kamorrissey/SolarDaisy/kicad/solar-light-charlie-boost/solar-light-charlie-boost.jpg

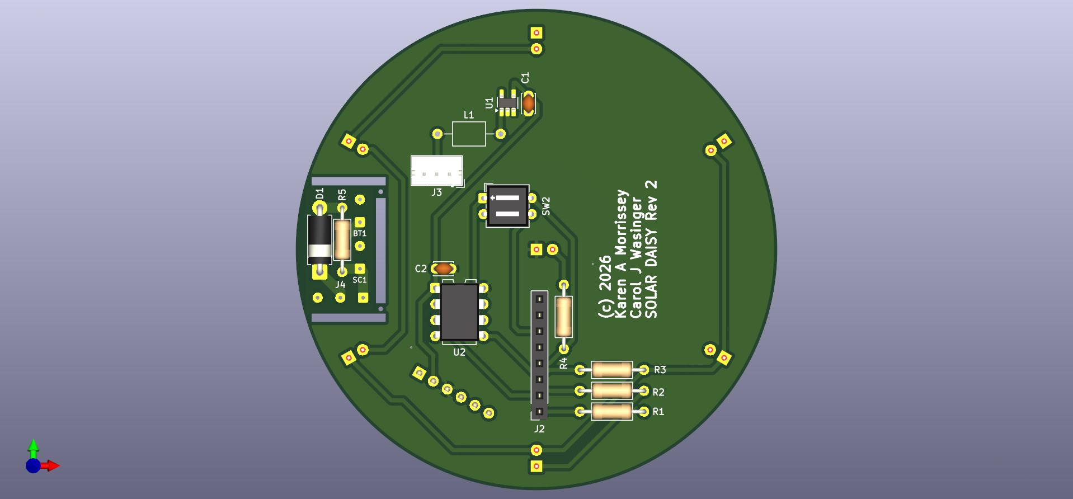
kicad/solar-light-charlie-boost/solar-light-charlie-boost.jpg
