kamorrissey/SolarDaisy/artifacts/gerbers-charlie-boost-v2a/solar-light-charlie-boost.csv

Id | Designator | Footprint | Quantity | Designation | Supplier and ref
1 | D1 | D_DO-15_P10.16mm_Horizontal | 1 | 1N5817
2 | C3,C1 | C_Disc_D3.0mm_W2.0mm_P2.50mm | 2 | 10uF
3 | R7,R8 | R_Axial_DIN0207_L6.3mm_D2.5mm_P10.16mm_Horizontal | 2 | 10K
4 | SC1 | SolderWire-0.1sqmm_1x02_P3.6mm_D0.4mm_OD1mm | 1 | 2V 130mA
5 | R5 | R_Axial_DIN0207_L6.3mm_D2.5mm_P10.16mm_Horizontal | 1 | 0R
6 | R2,R3,R1 | R_Axial_DIN0207_L6.3mm_D2.5mm_P10.16mm_Horizontal | 3 | 47R
7 | U1 | SOT-23-5_HandSoldering | 1 | TPS613221ADBVR
8 | R4 | R_Axial_DIN0207_L6.3mm_D2.5mm_P10.16mm_Horizontal | 1 | 100R
9 | R6 | R_Axial_DIN0207_L6.3mm_D2.5mm_P10.16mm_Horizontal | 1 | 47K
10 | J3 | JST_PH_B3B-PH-K_1x03_P2.00mm_Vertical | 1 | Conn_01x03_Pin
11 | U2 | DIP-8_W7.62mm | 1 | PIC12F1572
12 | J4 | SolderWire-0.1sqmm_1x03_P3.6mm_D0.4mm_OD1mm | 1 | Conn_01x03_Socket
13 | L1 | L_Axial_L5.0mm_D3.6mm_P10.00mm_Horizontal_Murata_BL01RN1A2A2 | 1 | 10uH
14 | C2 | C_Disc_D3.0mm_W2.0mm_P2.50mm | 1 | 100nF
15 | BT1 | SolderWire-0.1sqmm_1x02_P3.6mm_D0.4mm_OD1mm | 1 | NiMH 1.2V 1300mAh
16 | J2 | PinSocket_1x08_P2.54mm_Vertical | 1 | Conn_01x08_Socket
17 | SW2 | SW_DIP_SPSTx02_Slide_6.7x6.64mm_W7.62mm_P2.54mm_LowProfile | 1 | SW_DIP_x02
18 | D8,D6,D7,D2,D5,D4,D3 | LED_D5.0mm | 7 | LED
19 | J5 | PinHeader_1x06_P2.54mm_Horizontal | 1 | ICSP
