kamorrissey/SolarDaisy/solidworks/MainBoard.SLDPRT

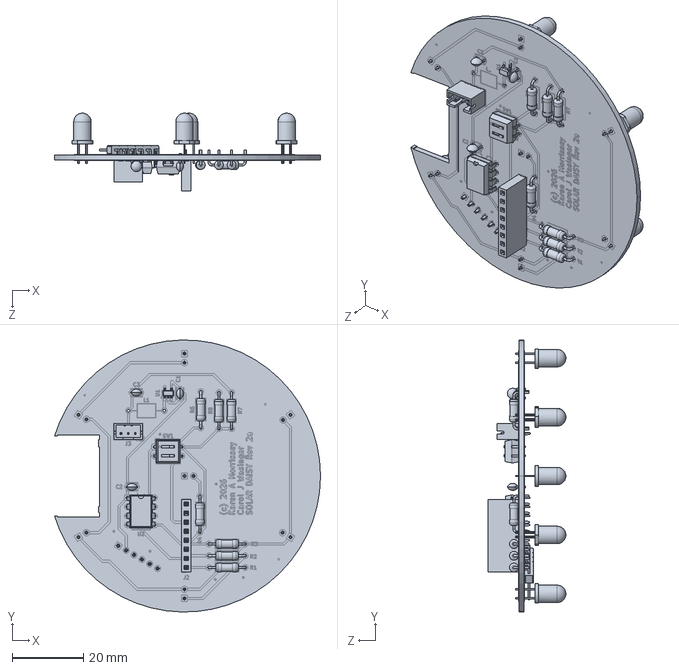
[picture p2: CAD file, 2026-11-04]
solidworks/MainBoard.SLDPRT
74.5 x 76.2 x 21.8 mm
