kamorrissey/SolarDaisy/solidworks/SolarDaisy 2026.SLDASM

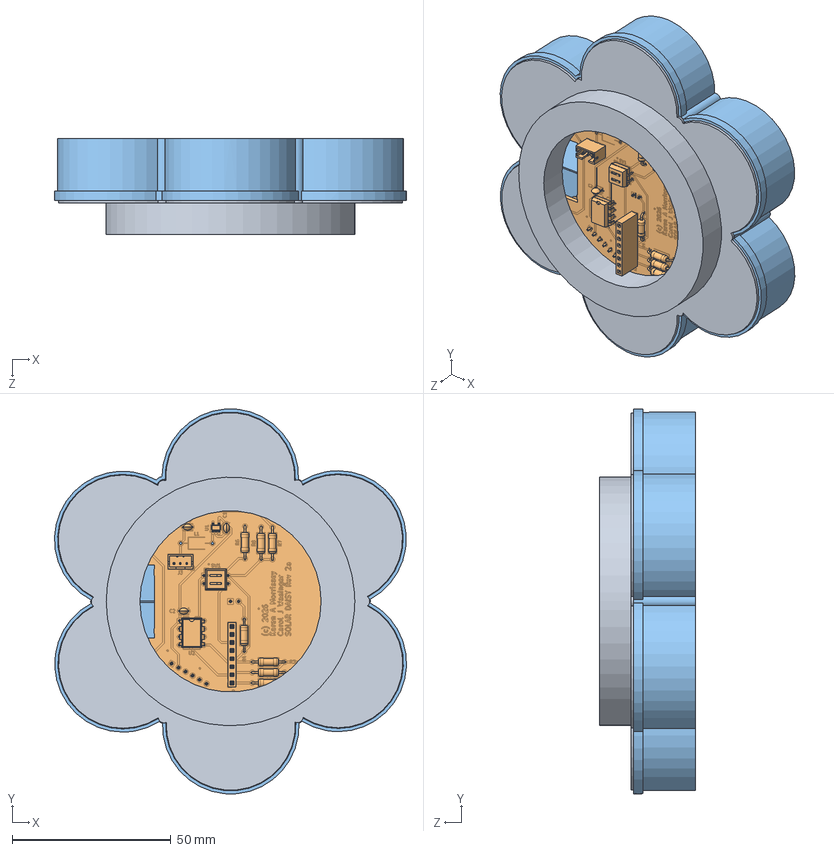
[picture p3: CAD file, 2026-11-04]
solidworks/SolarDaisy 2026.SLDASM
110.8 x 121.1 x 30.3 mm
SolarDaisyFace
MainBoard
SolarDaisyBack 2026
