kamorrissey/SolarDaisy/solidworks/SolarDaisyFace.SLDPRT

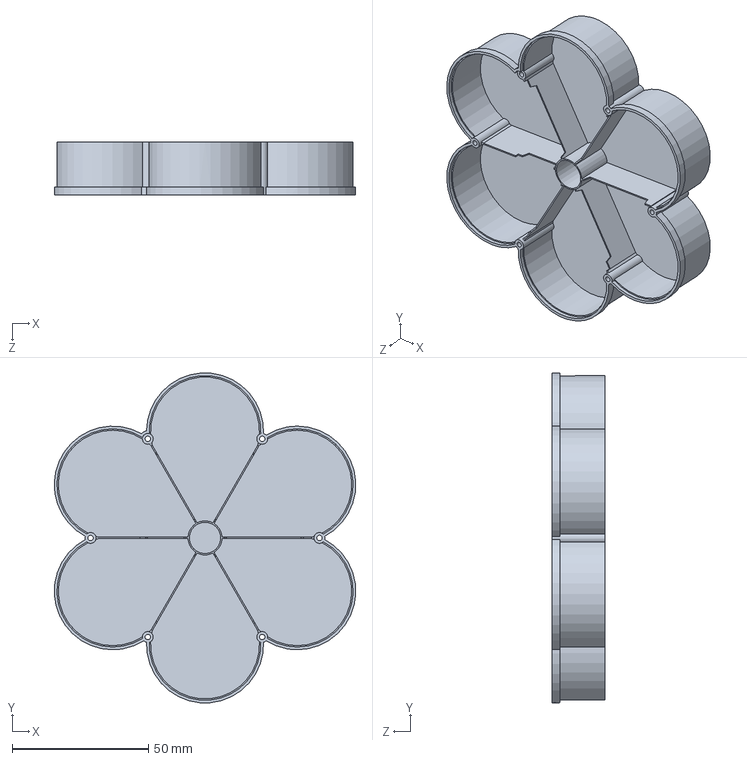
[picture p4: CAD file, 2026-11-04]
solidworks/SolarDaisyFace.SLDPRT
110.7 x 121.1 x 19.5 mm
