kamorrissey/SolarDaisy/solidworks/SolarDaisyBack 2026.SLDPRT

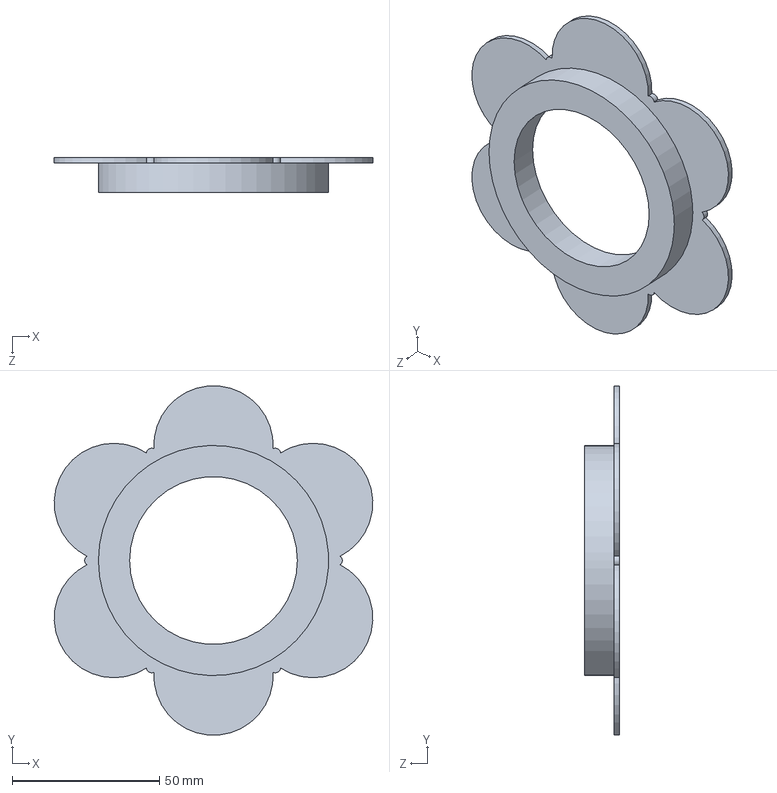
[picture p5: CAD file, 2026-11-04]
solidworks/SolarDaisyBack 2026.SLDPRT
108.3 x 118.6 x 12.0 mm
