kamorrissey/SolarDaisy/solidworks/solar-light-charlie-boost.step

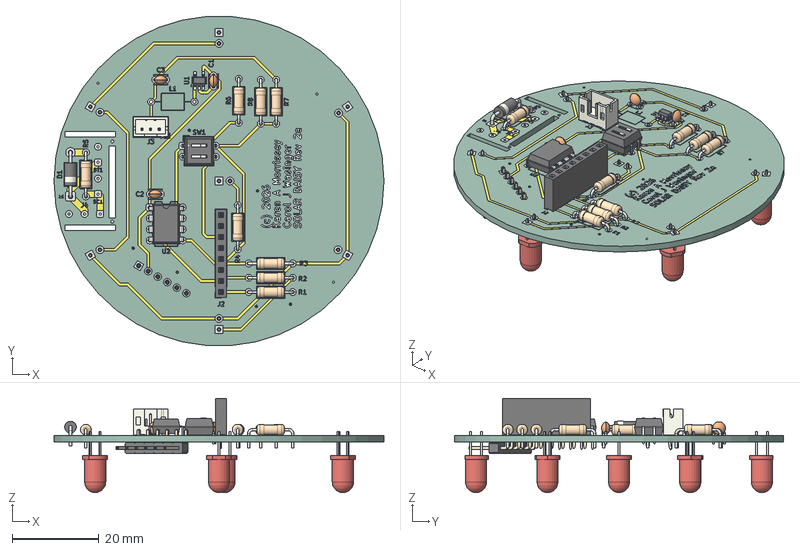
[picture p6: CAD file, 2026-11-04]
solidworks/solar-light-charlie-boost.step
76.2 x 76.0 x 21.8 mm
D_DO-41_SOD81_P10.16mm_Horizontal
R_Axial_DIN0207_L63mm_D25mm_P1016mm_Horizontal x 8
SOT-23-5
JST_B3B_PH_K
DIP-8_W7.62mm
C_Disc_D30mm_W20mm_P250mm x 3
PinSocket_1x08_P2.54mm_Vertical
SW_DIP_SPSTx02_Slide_67x664mm_W762mm_P254mm_LowProfile
LED_D5.0mm x 7
PinHeader_1x06_P254mm_Horizontal
solar-light-charlie-boost_copper
solar-light-charlie-boost_pad
solar-light-charlie-boost_via
solar-light-charlie-boost_silkscreen x 2
solar-light-charlie-boost_PCB
