kamorrissey/SolarDaisy/solidworks/BreakawayBoard.SLDPRT

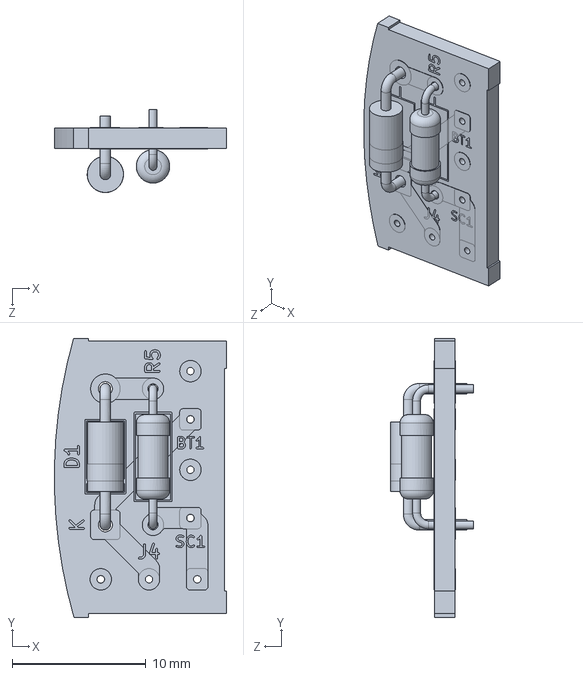
[picture p7: CAD file, 2026-11-04]
solidworks/BreakawayBoard.SLDPRT
12.8 x 20.8 x 6.21 mm
