kamorrissey/SolarDaisy/(list of files, cad)

Other CAD files:
solidworks/solar-light-charlie-boost.SLDPRT
