kamorrissey/SolarDaisy/artifacts/solar-light-charlie-boost.pdf

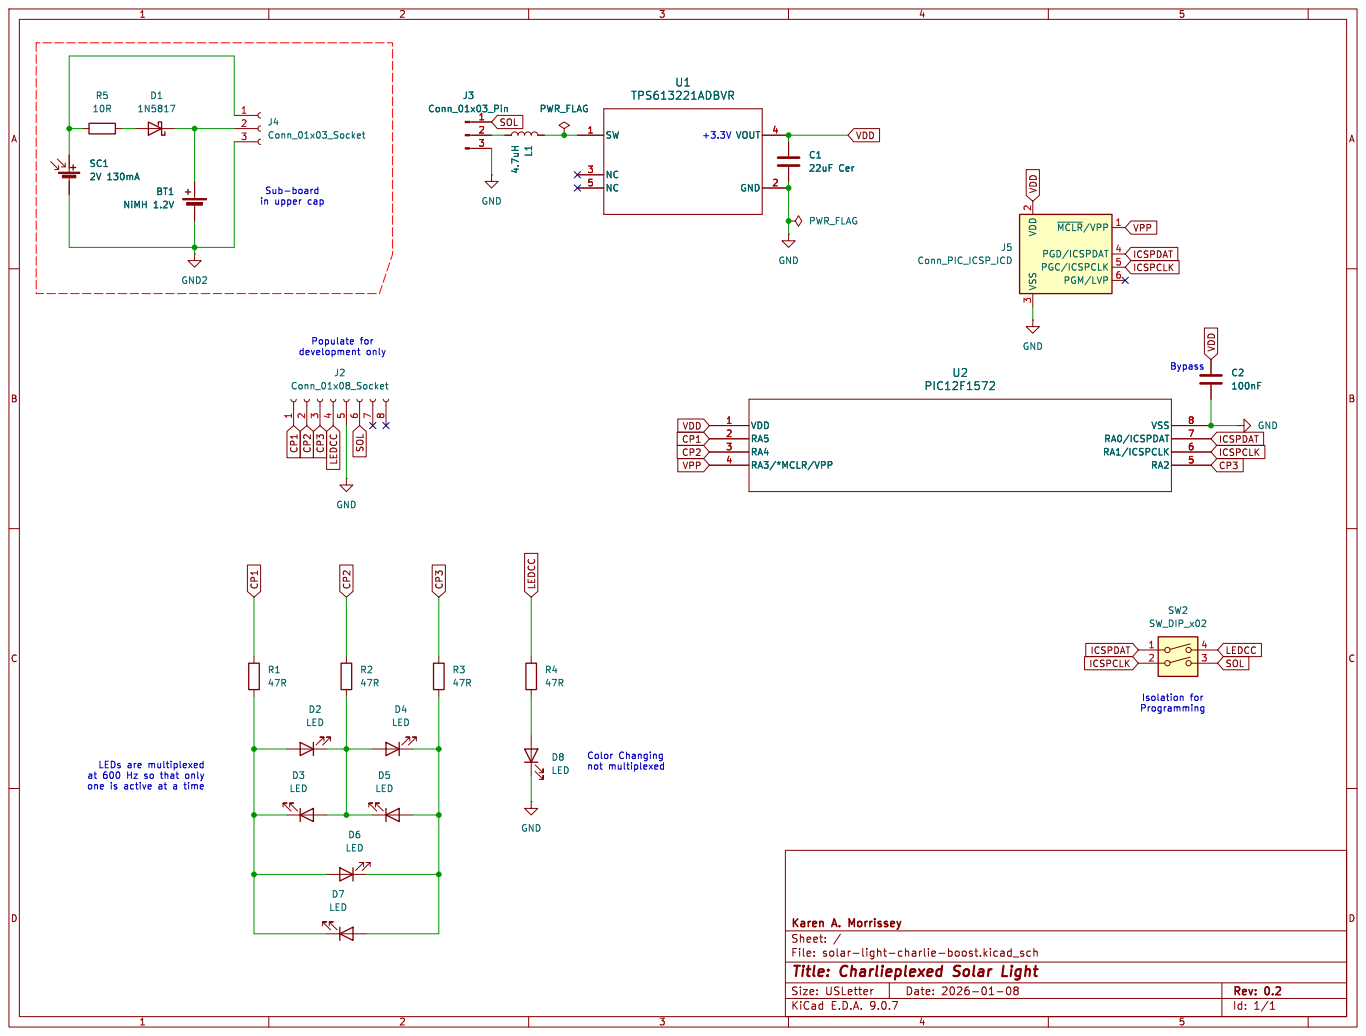
[picture p8: page 1]

3 ~{MCLR}/VPP1 PGD/ICSPDAT 4 PGC/ICSPCLK 5 PGM/LVP 6
