kamorrissey/SolarDaisy/kicad/solar-light-charlie-boost/solar-light-charlie-boost.kicad_pcb

## KiCad design kicad/solar-light-charlie-boost/solar-light-charlie-boost.kicad_pcb (2026-10-26)

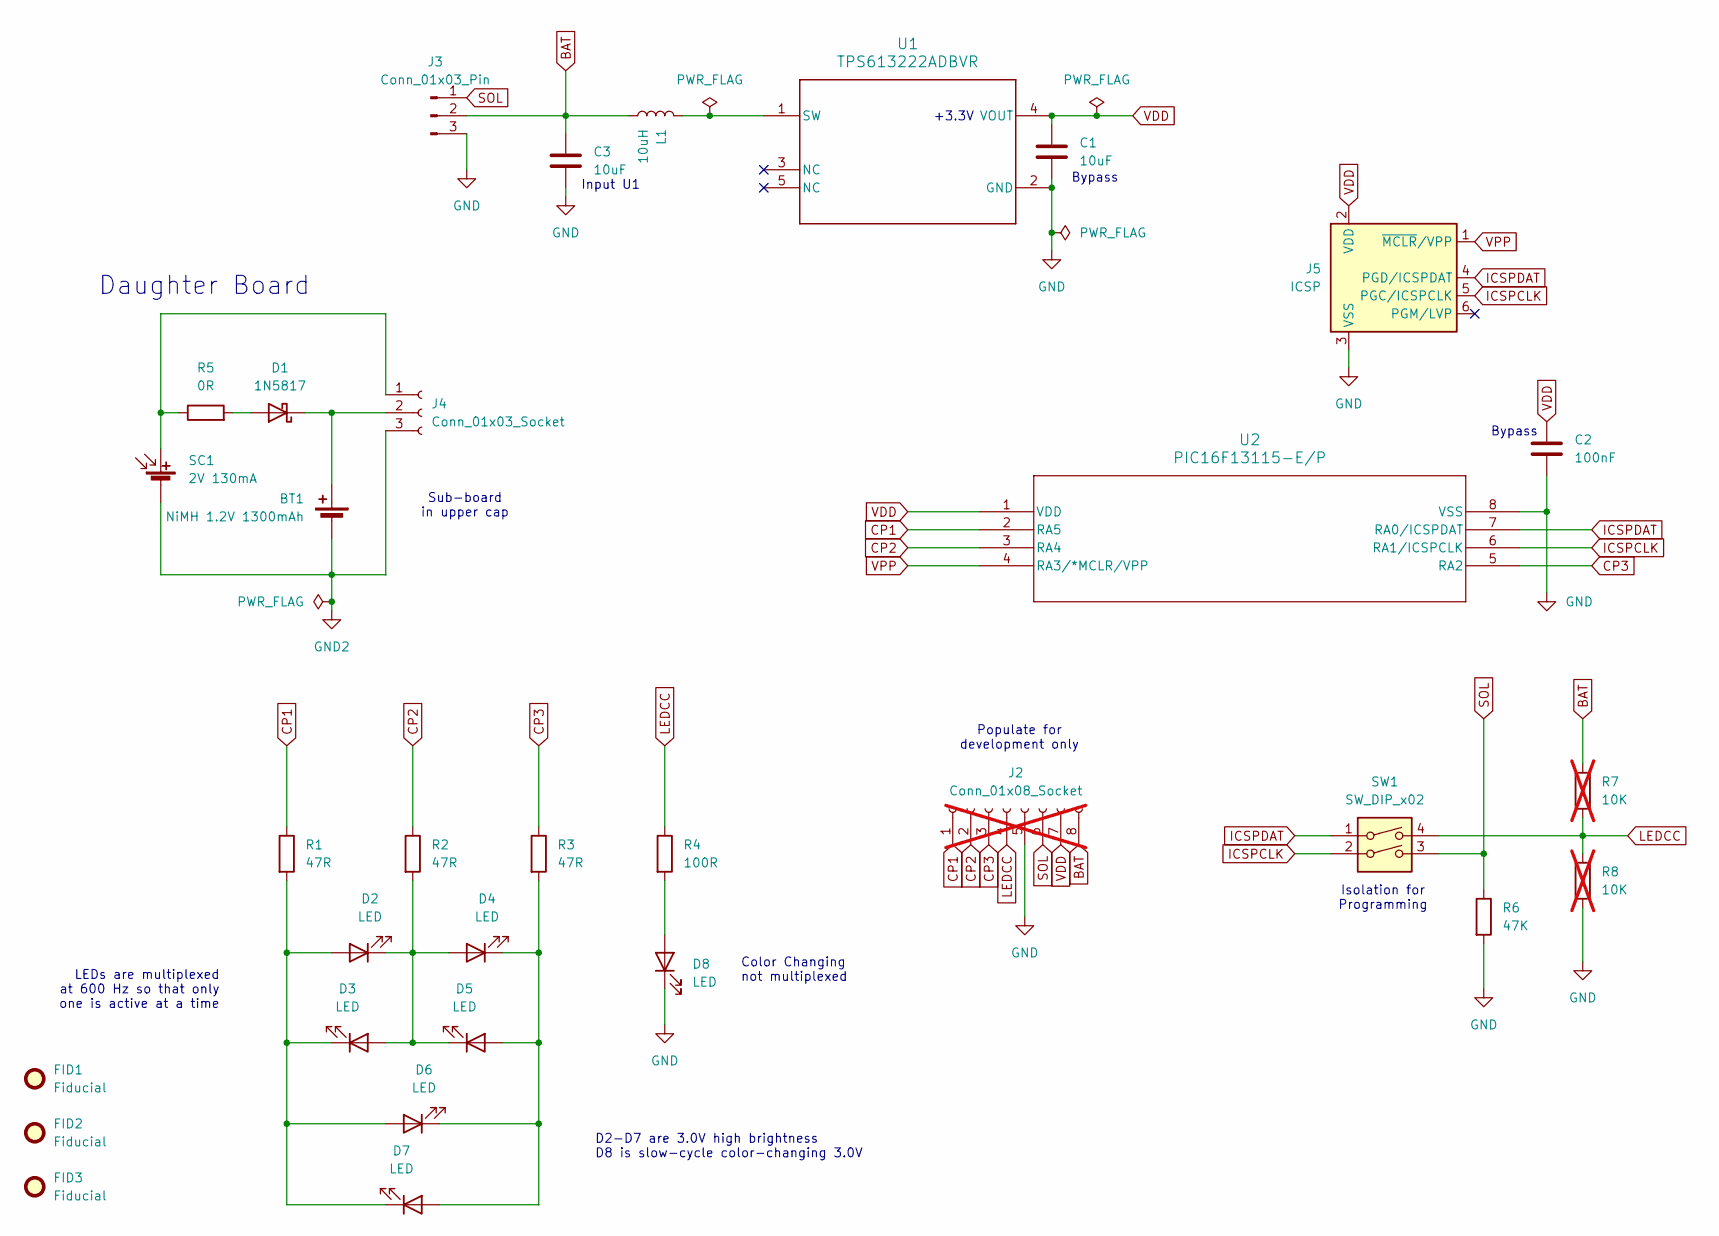
[picture p9: schematic solar-light-charlie-boost.kicad_sch, SOLAR DAISY]

Parts:
BT1: NiMH 1.2V 1300mAh; SolderWire-0.1sqmm_1x02_P3.6mm_D0.4mm_OD1mm
C1, C3: 10uF; C_Disc_D3.0mm_W2.0mm_P2.50mm
C2: 100nF; C_Disc_D3.0mm_W2.0mm_P2.50mm
D1: 1N5817; D_DO-41_SOD81_P10.16mm_Horizontal
D2, D3, D4, D5, D6, D7, D8: LED; LED_D5.0mm
FID1, FID2, FID3: Fiducial; Fiducial_0.5mm_Mask1mm
J2: Conn_01x08_Socket; PinSocket_1x08_P2.54mm_Vertical; not fitted
J3: Conn_01x03_Pin; JST_PH_B3B-PH-K_1x03_P2.00mm_Vertical
J4: Conn_01x03_Socket; SolderWire-0.1sqmm_1x03_P3.6mm_D0.4mm_OD1mm
J5: ICSP; PinHeader_1x06_P2.54mm_Horizontal
L1: 10uH; L_Axial_L5.0mm_D3.6mm_P10.00mm_Horizontal_Murata_BL01RN1A2A2
R1, R2, R3: 47R; R_Axial_DIN0207_L6.3mm_D2.5mm_P10.16mm_Horizontal
R4: 100R; R_Axial_DIN0207_L6.3mm_D2.5mm_P10.16mm_Horizontal
R5: 0R; R_Axial_DIN0207_L6.3mm_D2.5mm_P10.16mm_Horizontal
R6: 47K; R_Axial_DIN0207_L6.3mm_D2.5mm_P10.16mm_Horizontal
R7, R8: 10K; R_Axial_DIN0207_L6.3mm_D2.5mm_P10.16mm_Horizontal; not fitted
SC1: 2V 130mA; SolderWire-0.1sqmm_1x02_P3.6mm_D0.4mm_OD1mm
SW1: SW_DIP_x02; SW_DIP_SPSTx02_Slide_6.7x6.64mm_W7.62mm_P2.54mm_LowProfile
U1: TPS613222ADBVR; SOT-23-5_HandSoldering
U2: PIC16F13115-E/P; DIP-8_W7.62mm

Connections:
BAT: C3.1, J2.8, J3.2, L1.1, R7.1
CP1: J2.1, R1.1, U2.2 (RA5)
CP2: J2.2, R2.1, U2.3 (RA4)
CP3: J2.3, R3.1, U2.5 (RA2)
GND: C1.2, C2.1, C3.2, D8.1 (K), J2.5, J3.3, J5.3 (VSS), R6.2, R8.2, U1.2 (GND), U2.8 (VSS)
GND2: BT1.2 (-), J4.3, SC1.2 (-)
ICSPCLK: J5.5 (PGC/ICSPCLK), SW1.2, U2.6 (RA1/ICSPCLK)
ICSPDAT: J5.4 (PGD/ICSPDAT), SW1.1, U2.7 (RA0/ICSPDAT)
LEDCC: J2.4, R4.1, R7.2, R8.1, SW1.4
unnamed: BT1.1 (+), D1.1 (K), J4.2
unnamed: D1.2 (A), R5.2
unnamed: D2.2 (A), D3.1 (K), D6.2 (A), D7.1 (K), R1.2
unnamed: D2.1 (K), D3.2 (A), D4.2 (A), D5.1 (K), R2.2
unnamed: D4.1 (K), D5.2 (A), D6.1 (K), D7.2 (A), R3.2
unnamed: D8.2 (A), R4.2
unnamed: J4.1, R5.1, SC1.1 (+)
unnamed: L1.2, U1.1 (SW)
SOL: J2.6, J3.1, R6.1, SW1.3
VDD: C1.1, C2.2, J2.7, J5.2 (VDD), U1.4 (VOUT), U2.1 (VDD)
VPP: J5.1 (~MCLR/VPP), U2.4 (RA3/*MCLR/VPP)

Notes on the sheet:
Isolation for Programming
LEDs are multiplexed at 600 Hz so that only one is active at a time
+3.3V
Input U1
Daughter Board
Sub-board in upper cap
Bypass
D2-D7 are 3.0V high brightness D8 is slow-cycle color-changing 3.0V
Color Changing not multiplexed
Populate for development only

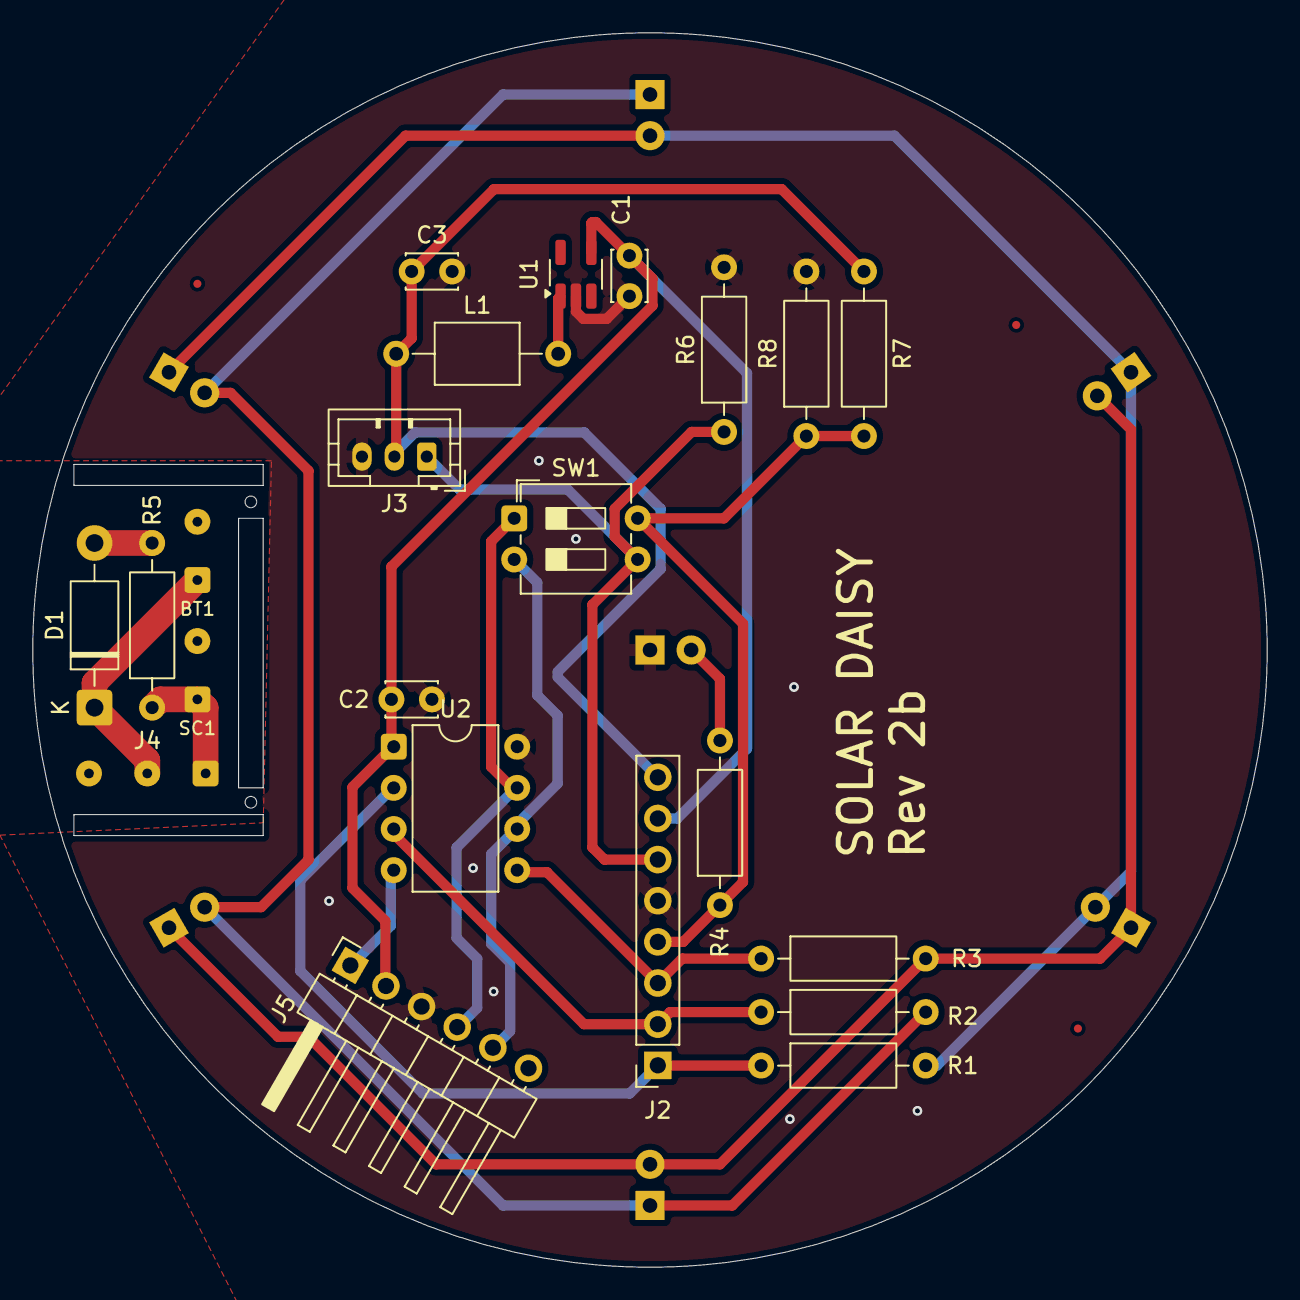
[picture p10: board solar-light-charlie-boost.kicad_pcb from above]

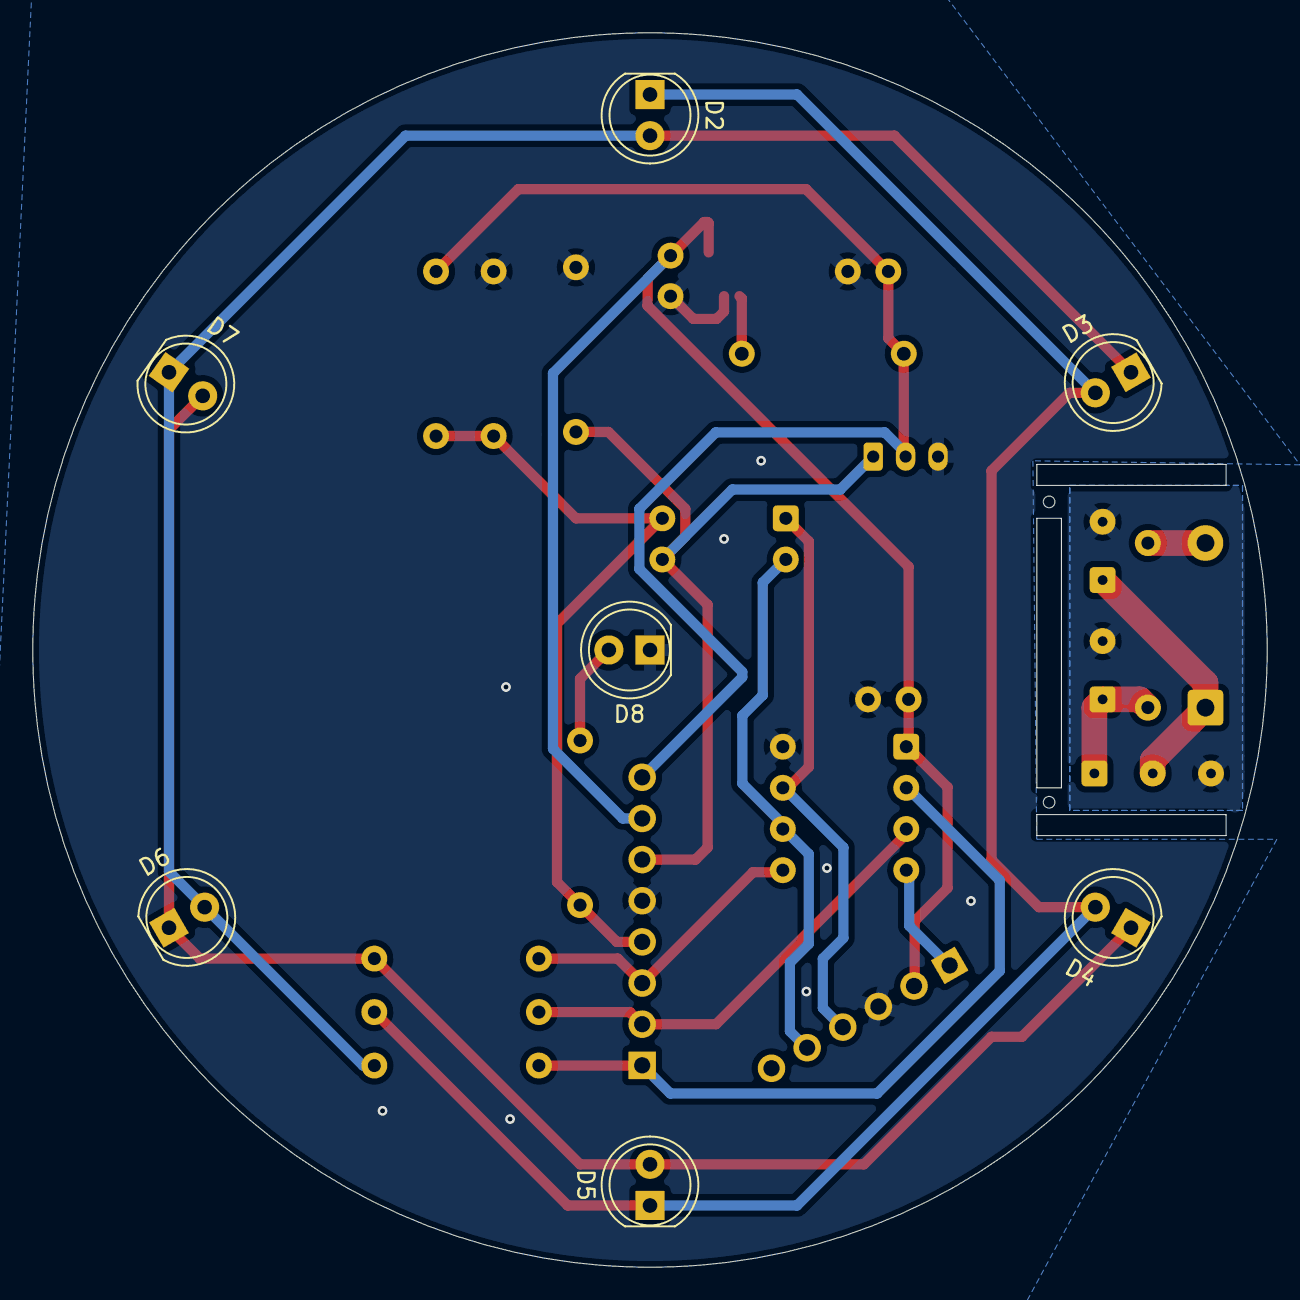
[picture p11: board solar-light-charlie-boost.kicad_pcb from below]

Board: 2 copper layers, 76.2 x 76.2 mm, 32 parts (7 on the bottom side), 20 nets.
