kamorrissey/SolarDaisy/mplab/solar-charlie-16f13115.X/app.h

/* 
 * File:   app.h
 * Author: kamor
 *
 * Created on February 3, 2026, 2:46 PM
 */

#ifndef APP_H
#define	APP_H

#ifdef	__cplusplus
extern "C" {
#endif

void APP_Initialize(void);
void APP_Run(void);

#ifdef	__cplusplus
}
#endif

#endif	/* APP_H */
