kamorrissey/SolarDaisy/(commit log)

2026-10-26 Make battery check optional and turn off
2026-10-26 Clean up bad footprints, make battery resistor divider DNP, and update PCB.
2026-10-26 Move J5 to board front; relabel board
2026-10-26 update to revision 2b; generate gerbers
2026-11-04 Revise README for 3D-printed design files
    Updated the README to improve clarity and formatting of file descriptions.
2026-11-05 Enhance README with detailed project description
    Expanded the introduction section with detailed information about the SolarDaisy's components and functionality, including the solar panel, battery, microcontroller, and LED animations.
